y18636313169-droid/flame-detector-UV-IR/docs/树莓派与火焰探测板通信协议.md

# 树莓派与火焰探测板配置通信协议

## 1. 文档状态

- 协议版本：V1.0
- 配置结构版本：1
- 主机：树莓派
- 从机：红外/紫外火焰探测板
- 通信口：USART2，115200 bit/s，8N1
- 调试口：USART1，仅承载命令行和文本日志
- 字节序：所有多字节整数均为小端
- 工作方式：严格停等，一次只允许一个未完成请求

本协议只开放正式运行所需的掉电配置。测试模式、调试打印、UV打印窗口、ADC旧阈值、ZCR兼容字段、报警恢复、LED和串口测试不开放远程配置。

## 2. 通信流程

```text
树莓派                                      火焰探测板
  |-- HANDSHAKE(nonce) ------------------------->|
  |<------------------------------ F0(success) --|
  |                                               |
  |-- GET_CONFIG -------------------------------->|
  |<---------------- CONFIG_DATA(0x81, 84 B) ----|
  |<------------------------------ F0(success) --|
  |                                               |
  |-- SET_xxx(value) ---------------------------->|
  |     校验整组参数、写EEPROM、读回、立即生效     |
  |<------------------------------ F0(success) --|
```

1. 树莓派先使用非零 nonce 建联，成功后才能读取或修改配置。
2. 会话有效期为最后一次收到完整合法请求后的 10 秒；存在半帧、DMA待处理数据或应答尚未物理发完时不清会话。
3. 建联后建议先读取全部配置，并以板端实际值作为修改基线。
4. 每个配置项使用独立 MessageID，一个 SET 只携带一个 `uint32_t` 值。
5. 从机写完 EEPROM 并读回一致、运行参数已生效后，才返回成功。
6. SET 失败只有统一失败结果。树莓派重新 GET_CONFIG 判断实际值，再决定是否重发。
7. 本版无心跳、主动上报、报警清除或报警状态消息。
8. UART错误、RX DMA覆盖或从机应答连续500ms无发送进展时，从机废弃当前交换并清除会话；树莓派必须重新握手。

## 3. 帧格式

```text
AA 55 | Version | PayloadLen | SequenceLE16 | MessageID | Data(N) | CRC16LE
 2 B      1 B        1 B          2 B           1 B       N B       2 B
```

| 字段 | 长度 | 定义 |
|---|---:|---|
| SOF | 2 B | 固定 `AA 55` |
| Version | 1 B | 固定 `0x10` |
| PayloadLen | 1 B | `Sequence(2)+MessageID(1)+Data(N)`，即 `N+3` |
| Sequence | 2 B | 1~65535，0非法，请求方和响应方分别维护自己的序号 |
| MessageID | 1 B | 业务消息编号 |
| Data | 0~119 B | 业务数据；受128字节单帧总长限制 |
| CRC16 | 2 B | CRC16/CCITT-FALSE，小端发送 |

### 3.1 长度字段与接收上限

完整帧长度为 `PayloadLen+6=N+9`。其中固定开销为9字节：SOF 2字节、Version 1字节、PayloadLen 1字节、Sequence 2字节、MessageID 1字节、CRC 2字节。因此128字节单帧总长限制对应业务Data最大119字节。CRC范围从 Sequence 第一个字节到 Data 最后一个字节，不包含 SOF、Version、PayloadLen 和 CRC。

| 长度名称 | 计算方法 | V1协议上限 |
|---|---|---:|
| 业务Data长度 `N` | 由MessageID定义 | 119 B |
| `PayloadLen` | `Sequence(2)+MessageID(1)+Data(N)` | 122 B (`0x7A`) |
| 完整帧长度 | `PayloadLen+6`，即`N+9` | 128 B |

CRC参数：Polynomial=`0x1021`，Init=`0xFFFF`，RefIn/RefOut=false，XorOut=`0x0000`。

接收器必须支持拆包和粘包。合法 `PayloadLen` 为3~122，完整帧最大128字节；候选帧100ms未接收完整时丢弃并重新搜索 `AA 55`。

## 4. 统一结果应答 0xF0

### 4.1 应答数据格式

`0xF0` 的 Data 永远固定为6字节，不附带配置数据或实际设置值：

| 偏移 | 字段 | 类型 | 定义 |
|---:|---|---|---|
| 0 | request_sequence | `uint16_t` | 原请求序号 |
| 2 | request_message_id | `uint8_t` | 原请求ID |
| 3 | result | `uint8_t` | 0成功，1失败 |
| 4 | error_code | `uint16_t` | 保留，V1固定为0 |

`0xF0` 完整帧为15字节。双方收到 `0xF0` 均不得再次应答，防止应答循环；探测板收到误发或回环的 `0xF0` 时静默丢弃，也不刷新10秒配置会话。

### 4.2 应答规则

- HANDSHAKE、GET_CONFIG和所有SET请求只要通过完整帧校验，均以F0给出最终成功或失败结果。
- GET_CONFIG成功时先发送0x81配置数据帧，再发送F0成功；GET_CONFIG失败时只发送F0失败，不发送配置数据。
- result只定义0和1，不通过F0区分长度、参数、存储或序号等失败原因。
- `error_code`为兼容既有F0六字节布局而保留，V1发送端必须填0，接收端不得依赖该字段判断失败原因。
- 帧头、版本、PayloadLen、CRC或Sequence=0等基础帧校验失败时直接丢弃，无法可靠匹配原请求，因此不返回F0。
- 未建联、未知SET ID、Data长度错误、参数非法、旧Sequence或同序号内容冲突等可识别请求返回F0失败，且不得修改配置。

## 5. MessageID

| ID | 名称 | 方向 | Data | 后续响应 |
|---:|---|---|---:|---|
| `0x80` | HANDSHAKE | 树莓派→探测板 | nonce，4 B | F0 |
| `0x81` | GET_CONFIG | 树莓派→探测板 | 0 B | 0x81配置数据帧，然后F0 |
| `0x81` | CONFIG_DATA | 探测板→树莓派 | 84 B纯配置快照 | 无；随后由探测板发送F0 |
| `0x90` | SET_SHOW_MODE | 树莓派→探测板 | value，4 B | F0 |
| `0x91` | SET_IR_PROFILE_ENABLED | 树莓派→探测板 | value，4 B | F0 |
| `0xA0` | SET_UV_SENSITIVITY | 树莓派→探测板 | value，4 B | F0 |
| `0xA1` | SET_UV_THR_MIN | 树莓派→探测板 | value，4 B | F0 |
| `0xA2` | SET_UV_THR_MAX | 树莓派→探测板 | value，4 B | F0 |
| `0xA3` | SET_UV_WIN_MIN_MS | 树莓派→探测板 | value，4 B | F0 |
| `0xA4` | SET_UV_WIN_MAX_MS | 树莓派→探测板 | value，4 B | F0 |
| `0xA5` | SET_UV_CFM_MIN_MS | 树莓派→探测板 | value，4 B | F0 |
| `0xA6` | SET_UV_CFM_MAX_MS | 树莓派→探测板 | value，4 B | F0 |
| `0xA7` | SET_UV_PW_MIN_US | 树莓派→探测板 | value，4 B | F0 |
| `0xA8` | SET_UV_PW_MAX_US | 树莓派→探测板 | value，4 B | F0 |
| `0xB0` | SET_IR_SENSITIVITY | 树莓派→探测板 | value，4 B | F0 |
| `0xB1` | SET_IR_POWER_MIN | 树莓派→探测板 | value，4 B | F0 |
| `0xB2` | SET_IR_POWER_MAX | 树莓派→探测板 | value，4 B | F0 |
| `0xB3` | SET_IR_R38_X1000 | 树莓派→探测板 | value，4 B | F0 |
| `0xB4` | SET_IR_R50_X1000 | 树莓派→探测板 | value，4 B | F0 |
| `0xB5` | SET_IR_FREQ_LOW_X10 | 树莓派→探测板 | value，4 B | F0 |
| `0xB6` | SET_IR_FREQ_HIGH_X10 | 树莓派→探测板 | value，4 B | F0 |
| `0xB7` | SET_IR_CFM_MIN_MS | 树莓派→探测板 | value，4 B | F0 |
| `0xB8` | SET_IR_CFM_MAX_MS | 树莓派→探测板 | value，4 B | F0 |
| `0xF0` | COMMAND_RESPONSE | 探测板→树莓派 | 固定6 B | 不应答 |

这些配置ID避开 bot_wheel 已使用的业务ID；`0xF0`保持 bot_wheel 的统一应答ID和固定布局。`0x81`由方向和Data长度区分：树莓派发送的0字节Data是读取请求，探测板发送的84字节Data是配置结果；其他长度均为非法。

## 6. 建联与序号规则

### 6.1 HANDSHAKE

请求 Data 为非零 `uint32_t nonce`。新握手成功后建立新会话，同时清除旧请求序号和去重响应缓存。

完全相同的握手重发只重放缓存F0。相同nonce但请求序号或内容不同，按新握手处理并重新建立序号域。

### 6.2 请求去重

- 树莓派重试必须保持原 Sequence、MessageID、Data 完全一致。
- 从机缓存最近一次已执行请求和它的全部响应帧。
- 完全相同的重复请求只重放缓存，不执行处理、不写 EEPROM。
- 相同 Sequence 但内容不同，返回失败且不覆盖缓存。
- 采用16位半区间规则判断新旧序号，旧请求返回失败且不执行。
- 新握手清空序号域，因此树莓派进程重启后可从任意非零序号重新开始。

树莓派等待响应超时建议为500ms，最多重试3次。

### 6.3 传输异常与重新建联

从机检测到UART错误、RX DMA覆盖或应答连续500ms无发送进展时，会丢弃当前收发残帧、清除请求去重缓存并结束会话。异常发生时不保证能够发送F0失败帧；树莓派等待超时后必须重新执行HANDSHAKE，不得直接沿用旧会话序号继续SET。

## 7. GET_CONFIG与包长

GET_CONFIG请求使用`MessageID=0x81`且Data长度必须为0。成功时从机连续发送两帧：

1. `CONFIG_DATA(0x81)`：Data仅包含固定84字节配置快照，不附加请求序号或应答字段。
2. `COMMAND_RESPONSE(0xF0)`：标记该GET成功完成。

CONFIG_DATA帧的Data为84字节，`PayloadLen=87(0x57)`，完整帧93字节。F0帧完整长度15字节，因此一次GET成功响应在线上共108字节，但它是两个各自有长度、序号和CRC的完整帧，不是一个108字节帧。两个单帧均小于128字节上限。

协议采用严格停等，树莓派发出GET后必须先接收并缓存0x81配置帧，再等到F0中的`request_sequence`和`request_message_id`与本次GET匹配且结果成功，才提交读取结果。任一帧缺失、顺序错误或CRC错误时，使用原GET请求完整重试；从机会按缓存原样重放两帧。

### 7.1 84字节配置快照

快照从0x81响应帧Data偏移0开始，不包含原请求序号：

| 快照偏移 | 字段 | 类型 | SET ID |
|---:|---|---|---:|
| 0 | config_schema_version，固定1 | u16 | - |
| 2 | field_count，固定20 | u16 | - |
| 4 | show_mode | u32 | `0x90` |
| 8 | ir_profile_enabled | u32 | `0x91` |
| 12 | uv_sensitivity | u32 | `0xA0` |
| 16 | uv_thr_min | u32 | `0xA1` |
| 20 | uv_thr_max | u32 | `0xA2` |
| 24 | uv_win_min_ms | u32 | `0xA3` |
| 28 | uv_win_max_ms | u32 | `0xA4` |
| 32 | uv_cfm_min_ms | u32 | `0xA5` |
| 36 | uv_cfm_max_ms | u32 | `0xA6` |
| 40 | uv_pw_min_us | u32 | `0xA7` |
| 44 | uv_pw_max_us | u32 | `0xA8` |
| 48 | ir_sensitivity | u32 | `0xB0` |
| 52 | ir_power_min | u32 | `0xB1` |
| 56 | ir_power_max | u32 | `0xB2` |
| 60 | ir_r38_x1000 | u32 | `0xB3` |
| 64 | ir_r50_x1000 | u32 | `0xB4` |
| 68 | ir_freq_low_x10 | u32 | `0xB5` |
| 72 | ir_freq_high_x10 | u32 | `0xB6` |
| 76 | ir_cfm_min_ms | u32 | `0xB7` |
| 80 | ir_cfm_max_ms | u32 | `0xB8` |

快照不包含编译器结构体填充、EEPROM魔数、CRC、测试字段或兼容占位字段；树莓派必须按固定偏移解码，不能直接转换为C/C++结构体。

## 8. 参数范围

### 8.1 SYSTEM

| ID | 默认 | 范围 | 含义 |
|---:|---:|---:|---|
| `0x90` | 0 | 0~1 | 0为UV&&IR正常模式，1为仅UV演示模式 |
| `0x91` | 1 | 0~1 | IR打火机包络识别开关 |

测试模式不开放远程配置，避免正式设备被远程切入只采集、不报警的路径。

### 8.2 UV

| ID | 默认 | 合法范围/约束 |
|---:|---:|---|
| `0xA0` | 5 | 0~9，0最灵敏 |
| `0xA1` | 5 | 1~64，且不大于thr_max |
| `0xA2` | 24 | 1~64，且不小于thr_min |
| `0xA3` | 1000ms | 100~60000，且不大于win_max |
| `0xA4` | 3500ms | 100~60000，且不小于win_min |
| `0xA5` | 0ms | 0~60000，且不大于cfm_max |
| `0xA6` | 3500ms | 0~60000，且不小于cfm_min |
| `0xA7` | 6000us | 1~65535，且不大于pw_max |
| `0xA8` | 14000us | 1~65535，且不小于pw_min |

### 8.3 IR

| ID | 默认 | 合法范围/约束 |
|---:|---:|---|
| `0xB0` | 5 | 0~9，0最灵敏 |
| `0xB1` | 12000 | 1~10000000，且不大于power_max |
| `0xB2` | 22000 | 1~10000000，且不小于power_min |
| `0xB3` | 1500 | 1~100000，表示R4.5/3.8乘1000 |
| `0xB4` | 1300 | 1~100000，表示R4.5/5.0乘1000 |
| `0xB5` | 10 | 10~200，且不大于freq_high；单位Hz乘10 |
| `0xB6` | 200 | 10~200，且不小于freq_low；单位Hz乘10 |
| `0xB7` | 200ms | 0~60000，且不大于cfm_max |
| `0xB8` | 3000ms | 0~60000，且不小于cfm_min |

min/max是独立请求，但每次均校验完整参数组。扩大区间时先修改外侧端点；收窄或整体平移时保证每一步的中间区间合法。

## 9. SET事务语义

```text
读取当前RAM参数组 -> 建立候选副本 -> 修改单字段 -> 校验完整参数组
-> 写EEPROM及CRC -> 逐字读回比较 -> 提交RAM副本 -> 更新运行参数 -> F0成功
```

- 任一步失败均返回F0失败，不应用新运行参数。
- 请求值与当前值相同时直接成功，不重复擦写EEPROM。
- 本实现不承诺多条SET之间的跨扇区原子性。异常掉电后，树莓派重新建联并GET_CONFIG，对不一致字段重新发送。
- SET配置不主动清除IR、UV或最终报警状态；SYSTEM现有模式切换接口自身规定的上下文重置行为保持不变。

## 10. 参考报文

以下报文属于同一次连续会话：树莓派请求序号为1、2、3；探测板发送序号因GET包含两帧而依次为1、2、3、4。

建联请求，Sequence=1，nonce=`0x12345678`：

```text
AA 55 10 07 01 00 80 78 56 34 12 85 BB
```

对应F0成功响应，假设从机发送Sequence=1：

```text
AA 55 10 09 01 00 F0 01 00 80 00 00 00 51 44
```

读取配置请求，Sequence=2：

```text
AA 55 10 03 02 00 81 55 23
```

按本文默认参数返回的0x81配置数据帧，探测板Sequence=2，Data为84字节：

```text
AA 55 10 57 02 00 81 01 00 14 00 00 00 00 00 01 00 00 00
05 00 00 00 05 00 00 00 18 00 00 00 E8 03 00 00 AC 0D 00 00
00 00 00 00 AC 0D 00 00 70 17 00 00 B0 36 00 00 05 00 00 00
E0 2E 00 00 F0 55 00 00 DC 05 00 00 14 05 00 00 0A 00 00 00
C8 00 00 00 C8 00 00 00 B8 0B 00 00 74 74
```

随后发送GET的F0成功完成帧，探测板Sequence=3：

```text
AA 55 10 09 03 00 F0 02 00 81 00 00 00 62 3A
```

设置UV灵敏度为5，请求Sequence=3：

```text
AA 55 10 07 03 00 A0 05 00 00 00 6D BF
```

其F0成功响应，探测板Sequence=4：

```text
AA 55 10 09 04 00 F0 03 00 A0 00 00 00 93 8F
```

## 11. 固件执行约束

1. 正常运行时USART2只有协议解析器一个接收消费者，不输出文本日志。
2. USART1继续用于命令行和调试打印。
3. RX任务每轮最多读取32字节且最多处理一个完整候选帧，防止通信饿死100Hz采样。
4. EEPROM写入、协议解析均在主循环执行，不进入ISR。
5. TX使用DMA并保存发送偏移，正确处理 `BSP_UART_Write()` 只接收部分字节的情况。
6. GET的0x81配置数据帧和F0按顺序发送；前一帧未全部入队前不得插入后一帧。
7. 响应全部进入队列后仍等待USART2 DMA物理发送完成，再允许处理下一请求。
8. 响应连续500ms没有入队或物理发送进展时，从机终止该交换并清除会话。
9. 本地测试模式可通过调试口执行`uart raw on`：该操作先清除协议会话和收发残留，再暂停协议任务，使`uart loop`和`uart recv`独占USART2。
10. 执行`uart raw off`或退出测试模式会清除原始测试残留并恢复协议；恢复后树莓派必须重新握手。
