y18636313169-droid/flame-detector-UV-IR/docs/火焰检测模组后续测试方案.docx

火焰检测模组后续测试方案

红外三波段 + 紫外脉冲融合探测

项目 | 内容 | 项目 | 内容
文档版本 | V1.0 | 编制日期 | 2026-07-27
当前基线 | 算法等级 5 | 适用阶段 | 工程验证与参数定型
依据 | 当前固件、现有测试结果及测试材料清单 | 文档性质 | 内部测试执行文件

适用说明

本方案用于后续功能验证、边界摸底、参数定型和回归测试。文中引用的照度、调制频率和材料要求来自现有《测试材料清单》，不直接替代型式试验、认证试验或第三方实验室结论。

目录

# 一、测试背景与目标

## 1.1 当前测试基线

当前样机已完成四类初步测试，说明红外、紫外及点火包络分类已经具备基本可用性。这些结果属于工程摸底，不等同于重复性、边界性和标准符合性验证。后续测试应固定固件、参数和镜片版本，以统一数据口径扩大燃料、距离及干扰场景覆盖。

已测项目 | 条件 | 当前结果 | 后续需要确认
打火机 | 不同点火过程，近距离为主 | 可较好识别打火机瞬态 | 增加距离、持续点燃和重复点火矩阵，确认误报边界
卤素灯 | 连续照射约30分钟 | 未产生最终报警 | 补充照度、距离、闪烁和“卤素灯+真实火焰”测试
工业酒精 | 10 cm、30 cm火盆，距离约2 m | 正常燃烧可识别；后期极小火焰可能低于进场阈值 | 建立火盆尺寸、距离、火焰阶段和最小可探测能量边界
纸张 | 当前等级5 | UV已到FIRE；IR距确认约200 ms | 等级5重复验证，并向等级4、3确认稳定触发边界
户外太阳光 | 尚未测试 | 无结论 | 列为最高优先级，覆盖静态直射、角度、遮挡闪烁和阳光下真火

等级方向

当前算法中等级0最灵敏、等级9最迟钝。本文所称“提高灵敏度”是将等级数值调小，例如由5调整为4或3；不得把“降低等级数值”和“降低灵敏度”混为一谈。

## 1.2 后续测试目标

- 完成最终能力目标验证：30 cm火盆在35 m距离、115°总视场范围内能够被稳定识别。
- 验证不同燃料、火盆尺寸、距离和燃烧阶段下的探测能力，确定最小可靠火焰边界。
- 验证阳光、人工光、热源及其动态变化不会形成最终误报警。
- 验证干扰背景下真实火焰仍可被红外与紫外共同确认。
- 验证打火机瞬态的初始分类与报警结果；分类后的自动升级、释放和恢复逻辑暂不纳入本轮测试。
- 形成参数冻结前的特征数据库，并建立参数修改后的固定回归矩阵。

# 二、测试对象与配置基线

## 2.1 样机与版本冻结

每轮正式测试必须为样机建立唯一编号，并记录硬件版本、传感器批次、镜片编号与透过率、固件版本、参数区版本、供电电压和安装方式。更换镜片、传感器、放大电路或参数后，视为新的配置基线，不得与旧数据直接合并计算通过率。

项目 | 当前默认/基线 | 测试前要求
灵敏度等级 | 等级5 | 记录IR和UV实际等级；代表性扫描使用0/3/5/7/9
IR等级5 | ON约17555；OFF约7022；确认约1755 ms | 通过设备参数查询确认EEPROM实际值
IR固定特征 | 光谱比1.5/1.3；闪烁1~20 Hz | 记录ZCR死区和手动标定日期
UV等级5 | 阈值15；窗口约2388 ms；确认约1944 ms | 确认有效脉宽范围和实际参数
最终报警 | IR FIRE且UV FIRE | 同时记录两个单通道状态，不能只记录最终输出
报警结束方式 | 本轮不评价自动恢复 | 报警后由外部人为干预或RST脚复位

参数快照要求

正式测试开始前导出一次完整参数；测试过程中禁止临时修改参数。若因问题定位必须调参，应结束当前测试编号，建立新版本后重新执行。

恢复逻辑范围

本轮测试暂不评价报警自动清除、自动退回IDLE或自动重新布防。一旦进入最终报警，完成数据记录后仅通过外部人为干预或RST脚复位结束本次测试；自动恢复相关项目统一标记为待定。

## 2.2 测试阶段划分

阶段 | 目的 | 建议重复次数 | 结果处理
特征摸底 | 寻找能量、比例、频率、脉冲数和响应时间分布 | 每个点至少5次 | 允许无合格判据，但必须保留原始日志
边界确认 | 在距离、尺寸或等级临界点附近确认稳定性 | 每个点至少10次 | 报告成功率、最大/中位响应时间
冻结回归 | 参数冻结后验证既有火焰与干扰场景 | 核心点每项10次 | 按统一验收条件给出通过/失败
长期稳定 | 评估漂移、误报和缓冲/状态机长期行为 | 8小时或24小时 | 记录异常状态；不执行自动恢复验收

# 三、测试环境与安全要求

## 3.1 室内火焰测试环境

- 使用可控、通风良好且具备明火试验条件的场地；探测器与火源之间无遮挡。
- 探测器镜头中心与火源主要辐射区域基本等高，固定光轴，不手持样机。
- 背景采用低反射、非燃材料；移除镜面、玻璃和大面积金属反射面，或将其作为单独变量记录。
- 30 cm火盆远距离专项需要不小于40 m的直线测试通道；35 m测距以镜头光学中心到火盆中心为准。
- 基准场景建议温度20±5 ℃、相对湿度20%~80%、光路横向风速不高于0.5 m/s；超出时记录实测值。
- 近距离通用火焰测试使用1 m、2 m、3 m、5 m；30 cm火盆专项使用5~35 m测试轨道，最大距离不得小于35 m。
- 115°按总视场角定义：光轴为0°，左右边界分别为-57.5°和+57.5°；通过旋转探测器改变角度，火源位置和距离保持不变。
- 每次点火前记录环境照度、背景温度、风速、火盆尺寸、燃料种类和火焰稳定时间。

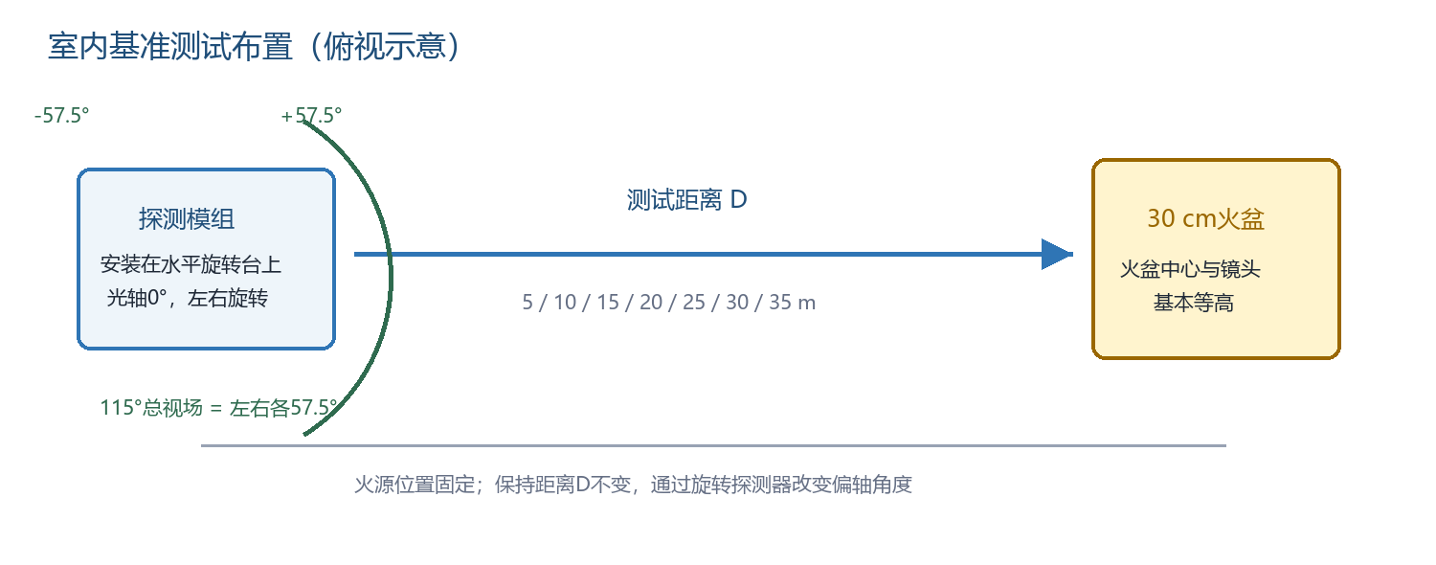
[picture p1: figure]

图1 室内基准测试布置

115°角度定义

本文按“总视场角115°”执行，即左右各57.5°。角度测试优先使用带刻度的水平旋转台，旋转中心应通过镜头光学中心。若产品需求中的115°实际指单侧偏角，而不是总夹角，则本矩阵必须重新定义，不能直接沿用。

## 3.2 户外太阳光环境

- 选择晴天或少云天气，在无遮挡室外区域测试；不得隔着普通玻璃替代太阳直射。
- 覆盖上午、正午和下午三个太阳高度阶段，记录时间、天气、照度和太阳相对镜头角度。
- 静态直射、斜入射和侧向照射分开执行；动态遮挡使用遮光板，不使用人员快速挥手靠近镜头。
- 阳光下真火测试必须保持火源与太阳方向可重复，并避免试验人员进入探测视场形成额外热源。

## 3.3 安全与试验中止条件

强制安全要求

明火、易燃液体、气体燃料、聚氨酯和高温热源试验必须由具备条件的人员执行。现场至少配备合适类型灭火器、防火毯、金属接液盘和紧急断电装置；液体燃料不得在热源附近补加，气瓶必须固定并使用合规减压、回火防止和检漏装置。

- 火焰失控、燃料外溢、容器变形、烟气无法排出、人员防护不足时立即中止。
- 出现供电异常、样机复位、串口日志中断、传感器饱和持续不恢复时中止并标记本次数据无效。
- 聚氨酯、塑料及烟气较大的材料应在具备废气处理能力的设施内测试，不在普通办公环境进行。
- 每轮试验后确认火源完全熄灭、容器降温；如已进入报警状态，由外部人为干预或RST脚复位后再开始下一项。

# 四、设备与材料

类别 | 设备/材料 | 关键要求 | 用途
记录 | 电脑、调试串口、视频或统一时钟 | 日志和视频时间可对齐 | 确认点火、IR/UV状态和最终报警时刻
测量 | 卷尺、照度计、温湿度计、风速计 | 量程覆盖现场条件 | 量化距离、照度和环境变量
温度 | 热电偶或红外测温仪 | 覆盖100~500 ℃ | 记录热源表面温度
人工光 | 白炽灯、荧光灯、LED、卤素灯、金卤灯 | 按清单规格准备 | 灯光静态和闪烁干扰
太阳光(重点测试) | 室外直射条件、遮光/调制装置 | 0/5/10/20 Hz可控更佳 | 日光静态、动态遮挡和组合测试
热源(重点测试) | 可调温加热器、黑体、电热板、焊台、热风枪 | 100~500 ℃分档 | 静态及动态热干扰
液体火 | 工业酒精、正庚烷+3%甲苯、汽油、柴油、煤油 | 统一批次并记录实际配比 | 氢型、碳型和扩展燃料覆盖
固体火 | 纸张/纸板、木条、聚氨酯泡沫、棉绳 | 尺寸、质量和摆放方式一致 | 快速火、低频火、烟气火和阴燃
气体火 | 甲烷或丙烷及合规燃烧器 | 气路安全、流量可重复 | 清洁碳氢火焰
安全 | 灭火器、防火毯、接液盘、防护用品 | 试验前逐项检查 | 风险控制

# 五、数据记录与统一判定

## 5.1 必须记录的数据

类别 | 记录字段
样机 | 样机编号、硬件/固件/参数版本、镜片编号、供电、等级
环境 | 日期时间、温湿度、照度、风速、室内/室外、背景和反射物
火源 | 材料、容器尺寸、距离、燃烧阶段、点火方式、持续时间
红外 | 三通道平均能量、光谱比、ZCR、死区、IDLE/WARNING/FIRE、点火包络状态
紫外 | 窗口脉冲数、阈值、IDLE/WARNING/FIRE、脉冲溢出或丢失
报警 | 点火时刻、IR WARNING、IR FIRE、UV FIRE、最终报警、撤除/熄灭和人工复位时刻
结果 | 是否误报、是否漏报、响应时间、失败判据、日志文件名、视频文件名

## 5.2 时间定义

- 点火时刻：火源出现连续可见火焰的时刻；由视频或统一标记确定。
- 通道响应时间：对应IR FIRE或UV FIRE时刻减去点火时刻。
- 最终响应时间：最终报警输出时刻减去点火时刻。
- 复位时刻：测试结束后执行外部人为干预或RST脚复位的时刻；本轮不统计自动恢复时间。
- 近触发事件：未到最终报警，但单通道进入FIRE，或IR确认累计距离门槛不足500 ms；必须单独统计。

## 5.3 工程验收原则

对象 | 摸底阶段 | 冻结回归建议判据
真实火焰 | 记录是否触发及响应时间分布 | 核心点不少于9/10次最终报警；目标响应≤6 s，同时报告最大值
人工光/太阳光/热源 | 记录单通道状态和最接近报警的程度 | 试验期间及撤除后30 s内不得出现最终报警
打火机瞬态 | 记录LIGHTER识别率和峰值/稳定比 | 短时点燃不产生最终报警；连续点燃按产品定义单列评估
自动恢复 | 暂不执行 | 待产品恢复策略确定后另行制定测试；本轮只允许外部干预或RST复位
数据完整性 | 允许试验后补充说明 | 日志、环境、配置、视频和结论缺一项即不纳入通过率

响应时间口径

“≤6秒”作为当前工程目标，用于比较优化效果；材料清单中的30秒要求可作为较宽的上限参考。报告中应同时给出中位数、最大值和成功率，不能只选择最快一次。

# 六、统一执行流程

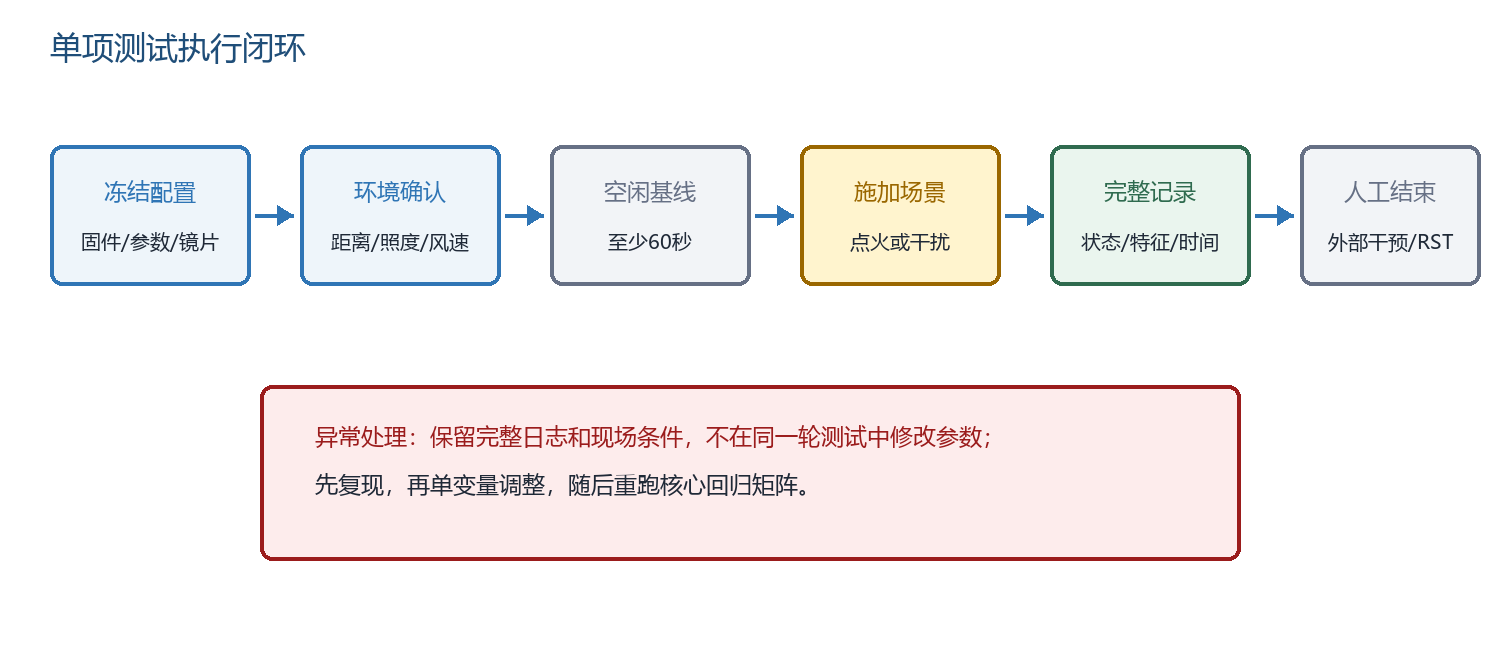
[picture p2: figure]

图2 单项测试执行闭环

1. 测试前预热样机至少5分钟，确认供电、串口、ADC和UV捕获稳定。
2. 在无火、无遮挡、无人走动条件下记录至少60秒基线；需要时执行手动ZCR死区标定。
3. 插入场景标记后开始点火或施加干扰，完整记录到状态稳定。
4. 真实火焰测试至少覆盖启动、稳定和衰减三个阶段；不得只截取最强燃烧阶段。
5. 熄火或撤除干扰后继续记录必要的结束状态；若进入FIRE，完成结果记录后由外部人为干预或RST脚复位，不等待自动恢复。
6. 同一测试点之间保持相同环境和操作；每次重复前确认火盆温度、剩余燃料和背景已恢复。

# 七、测试项目优先级

优先级 | 测试组 | 原因 | 完成标志
P0 | 户外太阳光 | 完全未测，是光学探测器最重要的误报场景之一 | 静态、角度、动态遮挡和阳光下真火均完成
P0 | 纸张等级边界 | 等级5仅差约200 ms，需确认重复性而非单次推断 | 等级5/4/3各完成重复测试并确定推荐等级
P0 | 30 cm火盆35 m/115° | 最终能力目标尚未做远距离和视场边界验证 | 完成轴向距离扫描、左右角度扫描及35 m边界重复验收
P0 | 酒精尺寸/距离边界 | 当前只验证2 m，且小火后期可能低于ON | 10 cm火盆完成近中距离矩阵；30 cm火盆完成5~35 m矩阵
P0 | 标准碳型火源 | 当前样本以酒精为主，燃料类型单一 | 正庚烷+甲苯完成核心距离点
P1 | 人工光和热源扩展 | 卤素灯已测，但缺少其他光源、闪烁和高温热源 | 全部清单光源及100~500 ℃热源完成
P1 | 干扰背景下真火 | 验证抗误报措施不会造成漏报 | 太阳光/灯光/热源背景下真实火焰均可识别
P1 | 其他燃料 | 验证不同辐射、烟气和闪烁特征 | 木材、纸板、汽油、柴油、煤油、气体火完成
P2 | 长期、温度、镜片与遮挡 | 验证漂移和硬件差异 | 24小时稳定性及关键硬件变量完成

# 八、详细测试项目

## 8.1 SUN：户外太阳光与模拟日光

编号 | 条件与布置 | 执行步骤 | 验收/记录重点
SUN-01 | 晴天正对太阳；上午、正午、下午；记录照度 | 每时段静态照射30 min | 无最终报警；统计IR/UV单通道最高状态
SUN-02 | 太阳相对光轴0°、±15°、±30°、90° | 每角度保持10 min，改变角度后先记录60 s基线 | 确定最危险入射角和光谱/脉冲变化
SUN-03 | 直射阳光+遮光板调制 | 0 Hz、5 Hz、10 Hz、20 Hz各60 s；能测时保持≥8000 lx | 试验中及结束后30 s无最终报警
SUN-04 | 云层快速变化、树影或固定遮光板缓慢扫过 | 覆盖慢变化和非周期遮挡，各10 min | 检查是否进入WARNING、是否累计证据
SUN-05 | 最危险太阳角度背景+10 cm酒精火盆2 m | 先照射5 min，再点火，重复5次 | 干扰背景下仍应最终报警，目标≤6 s
SUN-06 | 最危险太阳角度背景+纸张火2 m | 等级5先做5次；必要时等级4、3 | 确认UV不被背景占满，IR仍可完成确认

## 8.2 LGT：人工灯光干扰

编号 | 光源 | 模式 | 持续/次数 | 判定
LGT-01 | 白炽灯25 W×2 | 亮1 s/灭1 s | 20次 | 无最终报警；记录近触发事件
LGT-02 | 环形荧光灯30 W | 亮1 s/灭1 s | 20次 | 同上
LGT-03 | LED约20 W、6000 K | 1 s/1 s×10；2 s/2 s×10；持续亮30 s | 完整一组 | 同上
LGT-04 | 卤素灯约100 W | 持续、人工遮挡5/10/20 Hz | 持续30 min；调制各60 s | 复验现有结论并寻找动态边界
LGT-05 | 金卤灯 | 持续点亮 | 30 min | 无最终报警
LGT-06 | 最危险灯光背景+酒精/纸张火 | 灯光先稳定5 min后点火 | 每种火5次 | 最终报警，目标≤6 s

灯光应沿探测器光轴布置，并使用照度计在探测器位置测量。优先达到材料清单建议的约9000 lx；若设备能力不足，应记录实际最大照度，不得仅记录灯具功率代替照度。

## 8.3 HOT：热源干扰

编号 | 热源/温度 | 距离 | 步骤 | 验收重点
HOT-01 | 可调热源100/200/300/400/500 ℃ | 10/20/40 cm | 每温度稳定后照射5 min | 无最终报警；记录IR参考通道和P4.5变化
HOT-02 | 焊台或电烙铁300~400 ℃ | 10/20/40 cm | 静止、移入、移出各10次 | 移动热源不形成点火包络误判
HOT-03 | 热风枪100~500 ℃ | 安全距离按设备要求 | 低到高分档，每档3 min | 区分热气流、热源表面和机械扰动
HOT-04 | 热水容器90~100 ℃ | 10/20 cm | 持续10 min | 低温生活热源不报警
HOT-05 | 最危险热源背景+酒精火盆2 m | 热源近场、火源远场 | 热源稳定5 min后点火5次 | 真实火焰最终报警，目标≤6 s

## 8.4 FIR：真实火焰响应与距离边界

编号 | 火源 | 尺寸/距离 | 等级与次数 | 主要目的
FIR-01 | 工业酒精 | 10 cm火盆；2/5/10/15 m | 等级5，每点5次；边界点10次 | 确定小火盆可靠距离及衰减阶段漏检边界
FIR-02 | 工业酒精 | 30 cm火盆；5/10/15/20/25/30/35 m | 等级5，轴向每点5次；35 m不少于10次 | 建立轴向最大距离曲线并完成35 m目标验证
FIR-03 | 纸张/A4及瓦楞纸板 | 统一质量和摆放；1/2/3 m | 等级5/4/3，每点至少5次 | 解决等级5差约200 ms的问题并确定推荐等级
FIR-04 | 正庚烷+3%甲苯 | 标准钢制盘；2/3/5 m | 等级5，每点5次 | 补充典型碳型火源样本
FIR-05 | 汽油/柴油/煤油 | 同一容器和燃料层条件；2/3 m | 等级5，每种5次 | 覆盖强碳烟、中等IR和较弱UV差异
FIR-06 | 木条 | 尺寸与堆放一致；2/3 m | 等级5，每点5次 | 验证低频闪烁和逐步发展火焰
FIR-07 | 聚氨酯泡沫 | 受控小样；2/3 m | 等级5，每点5次 | 验证高烟气、强辐射材料；需专业排烟
FIR-08 | 甲烷或丙烷 | 固定燃烧器与流量；2/3 m | 等级5，每点5次 | 验证清洁气体火焰
FIR-09 | 棉绳阴燃 | 无明火；1/2 m | 持续30 min | 记录但允许不报警，明确产品为火焰探测而非烟雾探测

燃烧阶段必须完整覆盖

酒精和其他火源不能只测最旺阶段。每次至少记录点火启动、稳定燃烧、自然衰减或受控熄灭三个阶段，特别统计P4.5低于当前ON以后是否退出、是否重新进入以及UV是否仍保持FIRE。

## 8.5 ANG：30 cm火盆距离—角度专项

本专项是最终能力验收的核心。火源使用30 cm工业酒精火盆，火盆中心、镜头光学中心和测距基线保持不变。探测器安装在带刻度的水平旋转台上，0°表示光轴正对火源；负角为向左偏转，正角为向右偏转。115°总视场对应-57.5°至+57.5°，左右两侧必须分别测试，不能只测单侧后按对称性推断。

阶段 | 距离 | 角度 | 每点次数 | 目的
ANG-A 轴向距离 | 5/10/15/20/25/30/35 m | 0° | 5次；35 m为10次 | 先确认最大距离，避免角度结果混入距离不足因素
ANG-B 角度扫描 | 10/20/30/35 m | 0°、±15°、±30°、±45°、±52.5°、±57.5° | 每点3次；35 m每点5次 | 形成距离—角度二维响应图，检查左右不对称
ANG-C 边界精测 | 35 m | ±45°、±50°、±52.5°、±55°、±57.5° | 每点10次 | 确定115°边缘附近的可靠角度和衰减趋势
ANG-D 最终验收 | 35 m | 0°、-57.5°、+57.5° | 每点10次 | 验证轴向及115°两侧边缘均达到最终指标
ANG-E 垂直补充 | 20 m和35 m | 俯仰0°、±15°、±30°；如垂直也声明115°则加±57.5° | 每点5次 | 区分水平视场和垂直视场，不混用角度结论
ANG-F 尺寸对照 | 10 cm火盆的最大可靠轴向距离 | 0°、±30°、±45°、±57.5° | 每点5次 | 量化火盆尺寸对最大距离和边缘角度的影响

距离\角度 | -57.5° | -45° | -30° | 0° | +30° | +45° | +57.5°
5 m | □ | □ | □ | □ | □ | □ | □
10 m | □ | □ | □ | □ | □ | □ | □
15 m | □ | □ | □ | □ | □ | □ | □
20 m | □ | □ | □ | □ | □ | □ | □
25 m | □ | □ | □ | □ | □ | □ | □
30 m | □ | □ | □ | □ | □ | □ | □
35 m | □ | □ | □ | □ | □ | □ | □

表中每个格填写“报警成功次数/总次数、响应时间中位数、最大响应时间”。若某角度未通过，应在相邻角度之间以2.5°步进复测，得到实际可靠边界。对称保证视场角按左右两侧共同通过的较小边界计算：总视场角 = 2 × min（左侧可靠偏角，右侧可靠偏角）。

35 m测试的两种暴露方式

每个关键点同时执行两类测试：①从点火开始计时，覆盖启动到稳定燃烧全过程；②火焰稳定30~60秒后，用靠近探测器的耐热不反光遮挡板解除遮挡并计时，用于验证稳定火焰本身的远距离角度响应。两类结果必须分开记录。

最终验收判据

在当前冻结参数和等级5下，30 cm火盆、35 m距离、0°及±57.5°三个最终点均应完成IR与UV融合报警。每点建议不少于9/10次成功，最终响应时间工程目标不超过6秒。若±57.5°任一侧失败，则不能宣称达到115°总视场，应报告实际左右边界及保证视场角。

## 8.6 LTR：打火机及瞬态干扰

编号 | 距离 | 点燃方式 | 次数 | 判定重点
LTR-01 | 0.3/0.5/1/1.5/2 m | 点燃约3 s后熄灭 | 每点10次 | 应识别启动峰值衰减特征，不产生最终报警
LTR-02 | 0.3/0.5/1 m | 点燃10 s | 每点10次 | 记录LIGHTER分类和是否阻止最终报警；结束后人工/RST复位
LTR-03 | 待定 | 涉及LIGHTER自动升级SUSTAINED | 本轮不执行 | 待恢复策略确定后另行测试
LTR-04 | 待定 | 涉及自动释放和重新布防 | 本轮不执行 | 待恢复策略确定后另行测试
LTR-05 | 最易触发距离 | 吹风造成火焰摆动 | 5次 | 观察稳定能量和有效占比变化，禁止以单次峰值定性

短时打火机是当前明确的干扰目标；但连续保持的小火焰在物理上仍是真实火焰。持续小火焰是否允许报警以及LIGHTER是否自动升级为SUSTAINED，待产品恢复策略确定后另行测试。本轮只记录初次LIGHTER分类和最终报警结果，测试结束后通过外部人为干预或RST脚复位。

## 8.7 SEN：灵敏度与边界扫描

编号 | 项目 | 等级 | 方法 | 输出
SEN-01 | 无火背景 | 0/3/5/7/9 | 每级30 min | 各级近触发次数和误报情况
SEN-02 | 10 cm酒精火盆2 m | 0/3/5/7/9 | 每级5次 | 响应率和响应时间随等级变化
SEN-03 | 纸张火2 m | 5→4→3，必要时继续 | 每级至少5次 | 找到稳定触发的最高等级数值
SEN-04 | 打火机1 m | 0/3/5/7/9 | 每级10次短时点燃 | LIGHTER识别率和最终报警边界
SEN-05 | 最危险太阳光/热源 | 0/3/5 | 每级10 min | 提高灵敏度后的抗干扰裕量

## 8.8 CMB：组合场景

编号 | 背景 | 叠加火源 | 步骤 | 判定
CMB-01 | 太阳直射最危险角度 | 10 cm酒精火盆2 m | 背景5 min后点火 | 无背景误报；点火后最终报警
CMB-02 | 约9000 lx人工灯光 | 纸张火2 m | 灯光稳定后点火 | 确认IR和UV均有余量
CMB-03 | 300~500 ℃热源近场 | 酒精火盆2 m | 热源稳定后点火 | 热源不误报且不掩盖真实火焰
CMB-04 | 轻微横向风0.5/1/2 m/s | 酒精和纸张火 | 每风速各5次 | 评估火焰摆动和UV脉冲变化
CMB-05 | 镜片轻度污染或透过率样片 | 酒精/纸张核心点 | 每状态5次 | 量化光学衰减后的距离和等级裕量

## 8.9 REL：长期稳定与人工复位

编号 | 场景 | 时长 | 检查项
REL-01 | 室内无火、等级5 | 24 h | 误报、复位、串口异常、状态滞留、看门狗
REL-02 | 室内无火、等级0 | 8 h | 最灵敏设置下的背景裕量
REL-03 | 卤素灯或最危险人工光 | 2 h | 重复现有30 min结论并检查长期积累
REL-04 | 室外自然光昼间变化 | 日出后至日落前 | 日照角度和云层变化下的状态迁移
REL-05 | 自动恢复与重新布防 | 待定 | 本轮不执行；待产品恢复策略确定后补充
REL-06 | RST复位/断电重启与EEPROM参数 | 各20次 | 参数、死区、等级和状态初始化一致

# 九、问题定位与参数调整规则

现象 | 优先检查 | 禁止的处理方式
纸张只差少量确认时间 | 统计多次ACC峰值、IR判据失败项、UV/IR先后关系，再比较等级4和3 | 根据单次200 ms差值直接降低全部阈值
小酒精火后期退出 | 区分P4.5低于ON、低于OFF、光谱比失效或UV脉冲减少 | 把所有退出都归因于功率阈值
太阳光单通道FIRE但无最终报警 | 视为融合裕量风险，检查另一通道是否可能被其他干扰补齐 | 仅因最终输出未报警就判定完全通过
打火机被判持续火焰 | 检查启动峰值、稳定窗有效样本、稳定/峰值比例和提前收口时刻 | 通过调整恢复条件掩盖初始分类错误
真实火焰被判LIGHTER | 检查后段有效占比、稳定均值、提前收口时刻；自动升级测试暂缓 | 删除分类逻辑或在本轮引入未经验证的自动恢复
测试结果批次差异大 | 核对镜片、传感器、燃料批次、风速、照度、容器温度和参数快照 | 混合不同配置数据计算总体成功率

单变量原则

发现问题后先使用原配置复现，再一次只修改一个参数或一个硬件条件。任何影响进场阈值、确认时间、光谱比、ZCR、UV窗口或点火包络分类的修改，都必须重跑P0项目和对应抗干扰项目。

# 十、推荐执行顺序

阶段 | 建议内容 | 输出物
第1阶段 | 30 cm火盆5~35 m轴向距离、35 m/±57.5°预验证、纸张等级5/4/3 | 最大距离初判、115°边界风险、推荐等级
第2阶段 | 正庚烷+甲苯、木材、汽柴油/煤油、气体火 | 多燃料特征数据库和响应率
第3阶段 | 人工光全矩阵、热源全矩阵、打火机重复性 | 误报边界和点火包络分类统计
第4阶段 | 完整距离—角度矩阵及35 m边界精测；太阳光/灯光/热源背景下真火 | 35 m/115°验收结论及抗干扰平衡
第5阶段 | 等级扫描、镜片/污染变量、24 h长期测试 | 参数冻结建议和最终回归报告

十一、单次测试记录表

字段 | 记录内容 | 字段 | 记录内容
测试编号 | ________________ | 日期/人员 | ________________
样机/固件 | ________________ | 参数/等级 | ________________
镜片/传感器 | ________________ | 供电电压 | ________________
环境 | 温度____ 湿度____ 照度____ 风速____ | 场地/背景 | ________________
火源/干扰 | ________________ | 距离/角度 | D=____m；水平____°；俯仰____°
暴露方式 | 点火开始 / 稳定火焰解除遮挡 | 旋转方向 | 左 / 右；旋转台读数________
点火/施加时刻 | ________________ | 撤除/熄灭时刻 | ________________
IR WARNING/FIRE | ________________ | UV WARNING/FIRE | ________________
最终报警 | 是 / 否；时刻________ | 响应时间 | ________________
关键特征 | P38____ P45____ P50____ 比值____ ZCR____ | PROFILE | ________________
日志/视频 | ________________ | 结果 | 通过 / 失败 / 无效
异常说明 | ________________________________________________________________ | 复核人 | ________________

# 十二、测试完成判定

只有在P0项目全部完成、30 cm火盆35 m/115°专项达到验收要求、多燃料样本覆盖、主要干扰源无最终误报、组合场景下真实火焰仍能稳定报警、核心点达到重复性要求且长期测试未发现异常状态或异常复位后，才建议冻结当前参数。若仍存在“纸张临界”“小酒精火后期退出”或“太阳光单通道FIRE”等现象，应作为已知边界量化，不得仅以最终报警结果掩盖单通道风险。

本轮测试的首要结论

下一步优先执行30 cm火盆5~35 m轴向距离扫描和35 m、0°/±57.5°预验证，随后完成户外太阳光、纸张等级边界和标准碳型火源。35 m三个最终角度点通过后，仍需补齐中间距离—角度矩阵，才能形成完整的115°视场结论。

火焰检测模组 后续测试方案
