y18636313169-droid/flame-detector-UV-IR/(commit log)

2026-06-11 第一版本提交，包含基本功能，adc采集、过滤、打印，定时器捕获、打印；串口通信大纲；定时器中断；喂狗；紫外报警初步过滤；
2026-06-12 修改为3路adc检测不同波段的红外光源；修改定时器为双路配合检测，保留单路切换检测边沿代码；
2026-06-15 第二版本提交，适配3路ADC检测，双通道TIM捕获，硬件EEPROM存储，命令行框架，红外预留架构
    - ADC: 单通道改为3通道DMA连续扫描，AP层3路独立滑动滤波
    - TIM: 单通道极性切换改为双通道独立捕获(CH1上升沿清零CNT, CH2下降沿读CCR2)
    - EEPROM: STM32L151RE硬件DATA EEPROM封装，3扇区(ADC/UV/IR)分组存储
    - UV检测: 灵敏度等级0~9改为min/max范围+线性插值，参数变量可配置
    - 命令行: 独立RX任务(cmnd_parser_task)，param uv/ir/adc二级分发+保存
    - CRC: 公共模块modles/crc，支持Modbus+CCITT两种算法
    - IR预留: ap_ir.h/c框架，3路热电堆检测占位
    - 构建: 同步Keil uvprojx、EIDE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
2026-06-17 添加测试模式，仅打印红外ADC原始数据和紫外脉冲数据；添加cmd指令，可开关命令行，测试前打开，测试后关闭，防止空闲时间打印无效数据；添加不同mark信息，用于区分不同情况的测试场景，防止数据太多混乱；修改iwdg时间为10s；
2026-06-18 参照原理图对pin脚做修订，确定引脚和功能；删除adc无用接口，只取原始数据和处理后的数据；使用预编译区分测试模式和应用模式；led接口调用；
2026-06-24 初次测试直接打印ADC原始数据和捕捉到的紫外脉冲，不进行滤波操作
2026-07-02 添加紫外脉宽检测设置存储,考虑后续修改脉冲宽度,添加测试打印窗口,打印过去n秒窗口内的紫外脉冲数据;红外测试打印,ADC原始数据+均方值,图形化数据能较好观察出有火焰的情况,均方值线性缩小,便于观察;更新串口配置通道,USART1为调试口,2为通信口;添加cmd代码,便于调试;基础外设功能已验证;
2026-07-08 修改ir和uv的打印调试开关；
2026-07-21 修改测试接口，输出10s的平均均方值，方便对比镜片；
2026-07-23 完善IR/UV火焰检测算法与调试能力
    - 重构IR连续滤波、功率/ZCR独立窗口、固定死区标定及WARNING抗抖状态机
    - 增加动态4.5um进场阈值、打火机点火包络分类和无WARNING瞬态快速重布防
    - 完善UV窗口阈值、掉线检测、脉冲参数与火警保持逻辑
    - 升级EEPROM参数校验和版本迁移，补充CLI命令、调试日志及架构文档
2026-07-23 限制检测近距离打火机的入场阈值，减少真实火焰误判为打火机测试的情况
2026-07-23 修复着火后掉出回到bypass无法稳定的情况
2026-07-27 修改峰值检测窗口周期；修改从打火机->持续火焰燃烧的判定逻辑，误判后尽快恢复；
2026-07-28 提交火焰后续测试方案
2026-08-05 添加演示模式，特殊对待
2026-08-07 芯片ALARM引脚被击穿，永久对地导通，排查问题后确定是外部问题导致；
2026-08-21 将测试模式作为cmd包含进去，不再重复烧录固件；cmd增加是否检测打火机开关；
2026-09-08 初步修改红外的过零率算法内容，用fft替换频率检测；添加串口通信协议用于配置，功能待验证；
2026-09-16 添加代码注释
2026-09-18 加入STM32驱动依赖
2026-09-18 更新readme
2026-09-20 完善故障监测与树莓派状态查询协议
    新增统一故障管理及状态、报警、故障、设备信息查询消息。
    完善EEPROM读写状态与恢复出厂处理，并加入ADC采集、偏置和冻结异常监测。
    整理主循环故障任务及工程构建配置，同步Keil工程文件。
